Xinyuan-LilyGO/T-Motor/case/T-Motor.DXF

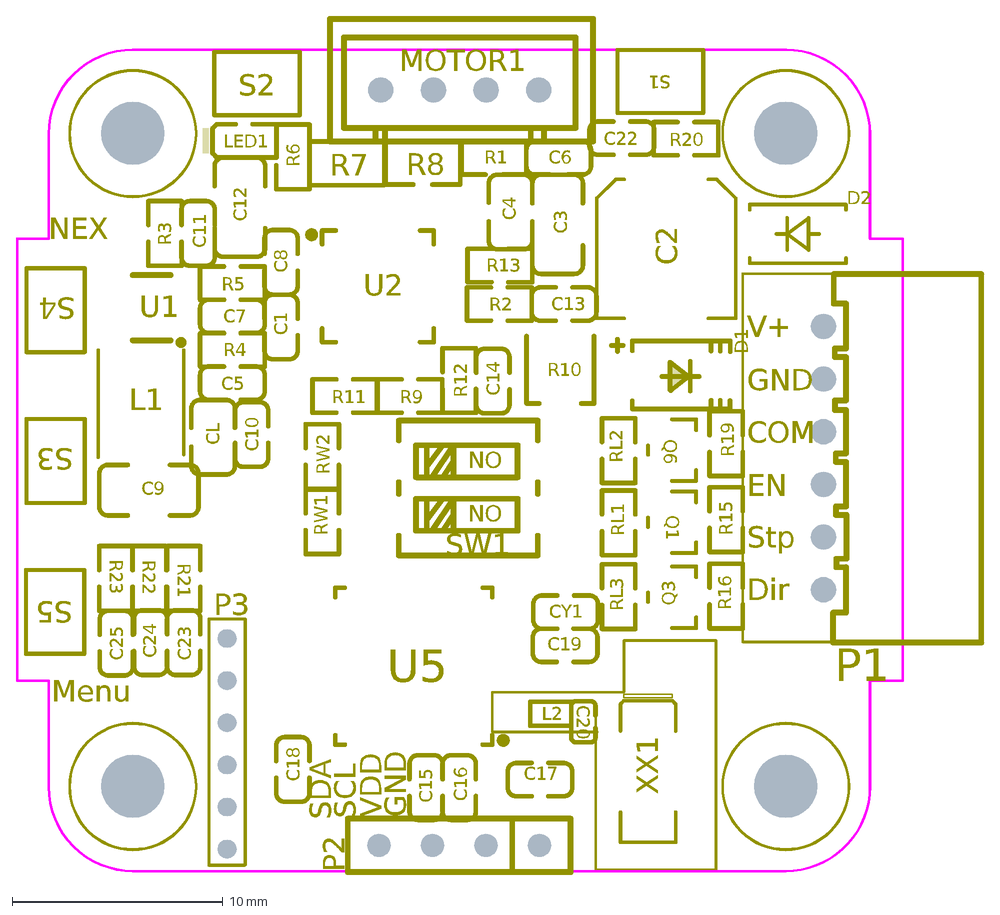
[picture p4: CAD file, 2025-07-31]
case/T-Motor.DXF
GND
VDD
SCL
SDA
Menu
NEX
Stp
Dir
COM
V+
EN
RL3
RL2
RL1
Q6
Q3
Q1
C19
D1
CL
U1
S5
S2
S4
S3
R23
R22
R21
C25
C24
C23
C2
XX1
U5
S1
R20
R13
R12
R11
R10
R9
R8
R7
R6
R2
R1
P3
P1
LED1
L2
D2
C22
C20
C17
C16
C15
C14
C13
C8
C12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
