Xinyuan-LilyGO/T-Motor/case/Shell.stl

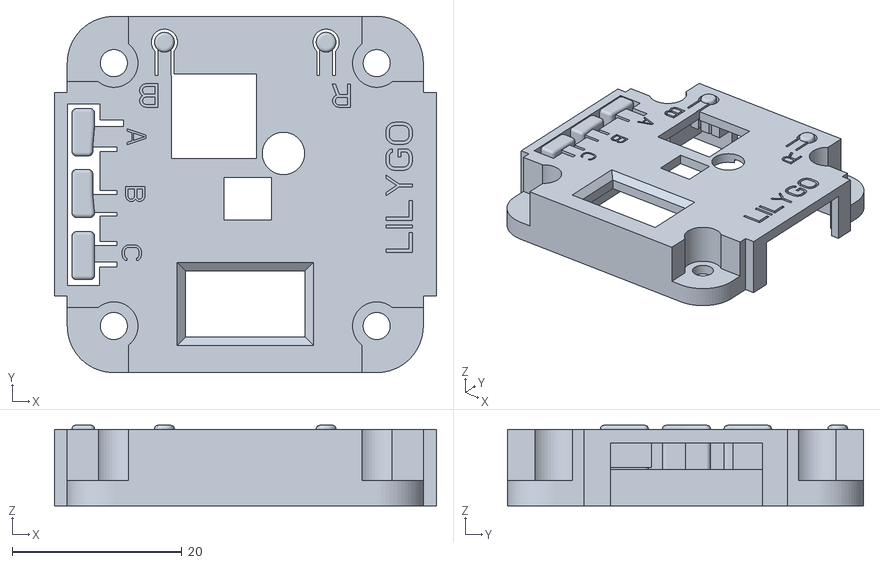
[picture p5: CAD file, 2021-11-24]
case/Shell.stl
45.1 x 42.0 x 9.50
