Xinyuan-LilyGO/T-Motor/Schematic/T-Motor.pdf

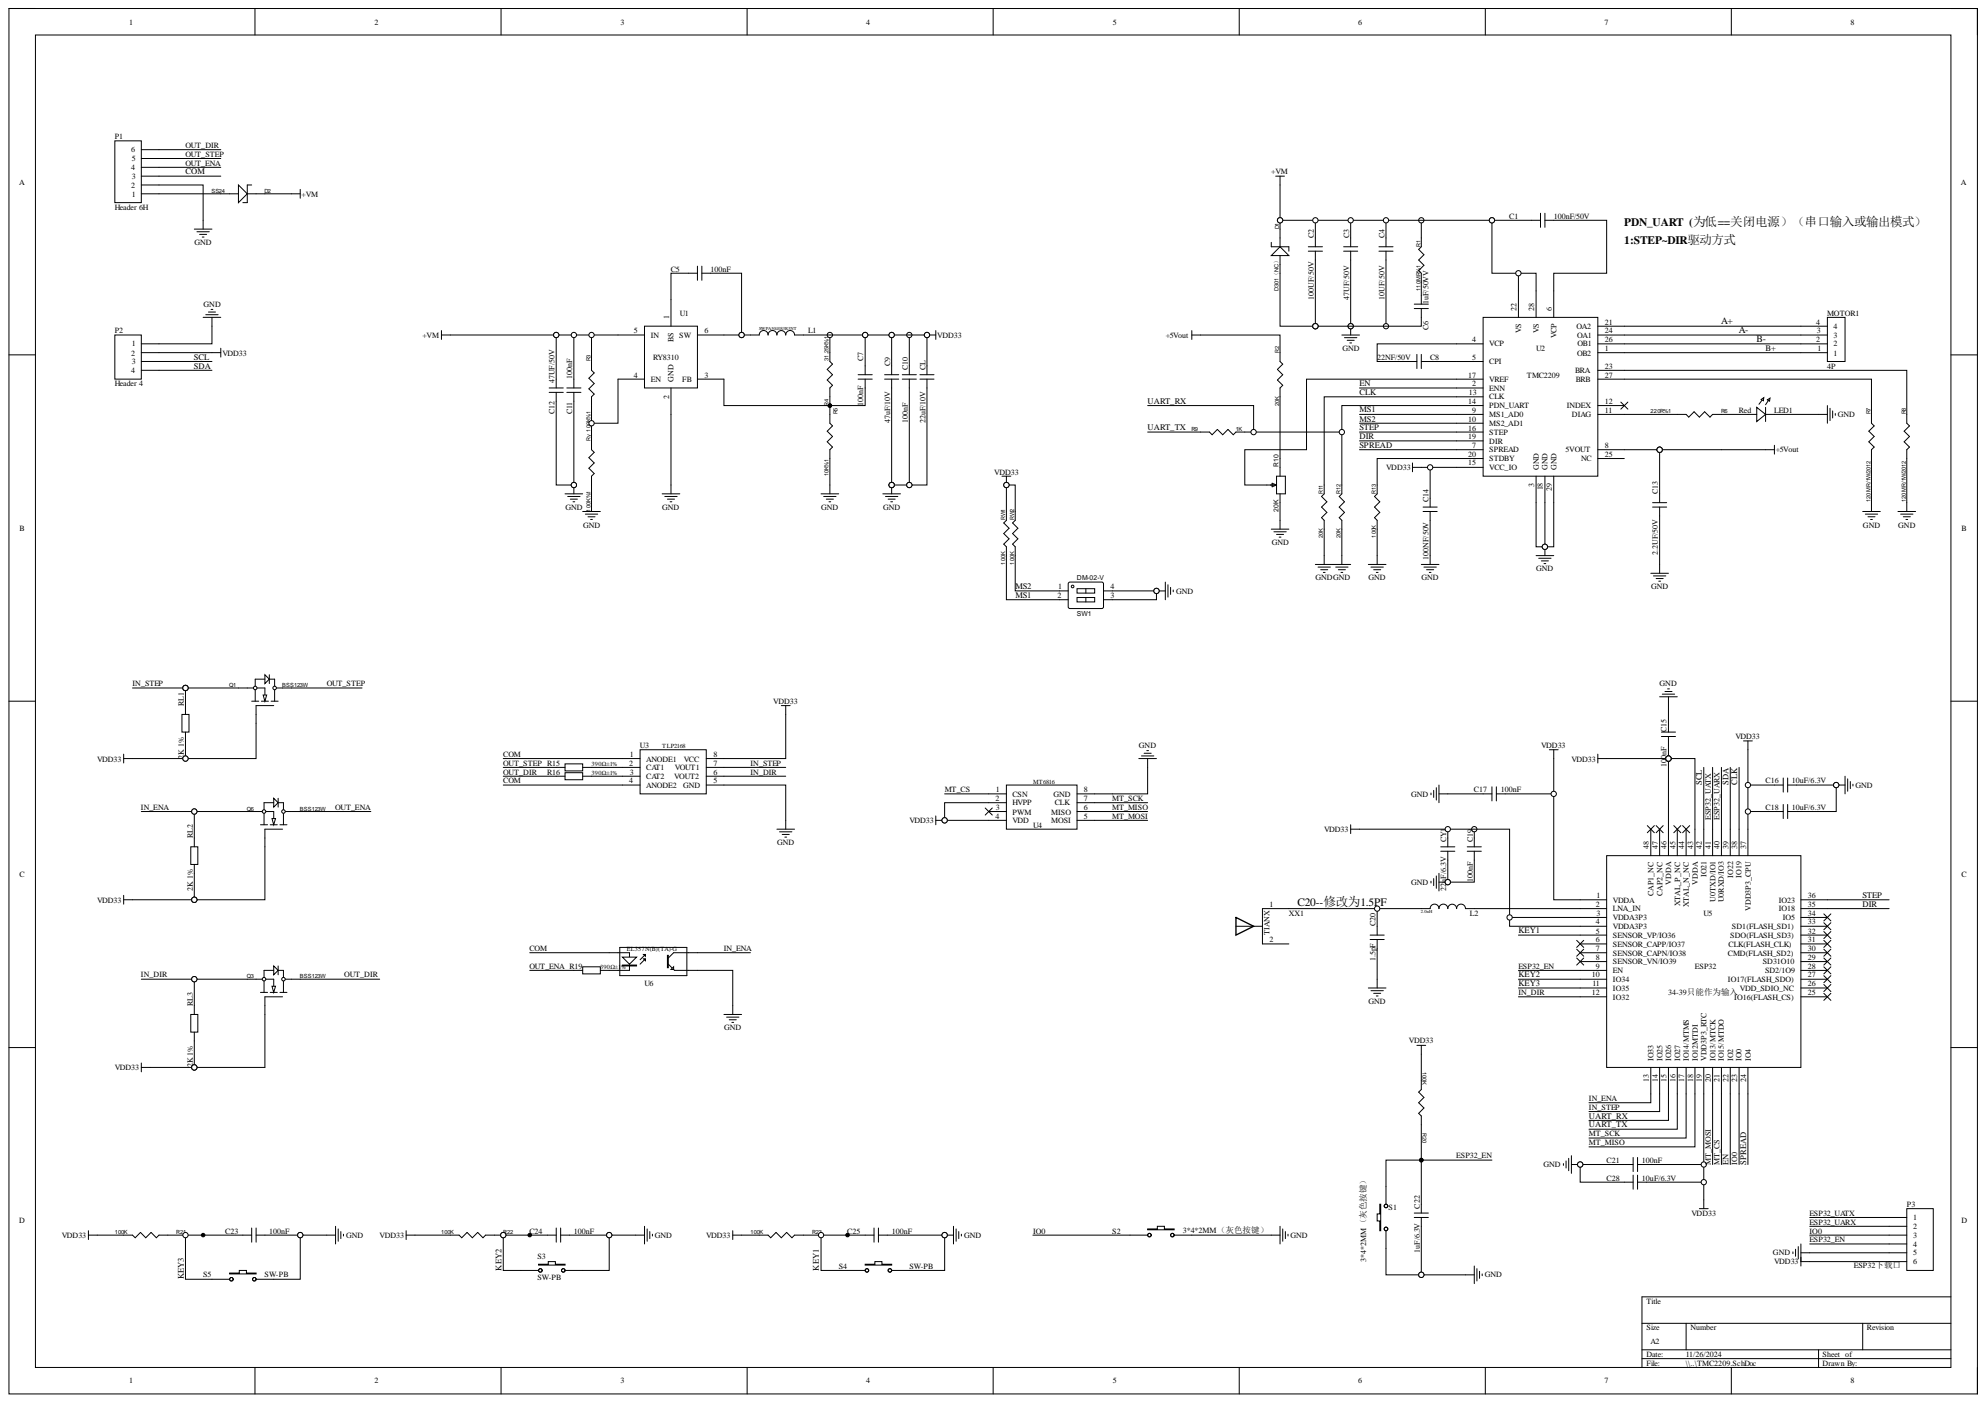
[picture p6: page 1]
