Xinyuan-LilyGO/T-Motor/(threads)

Thread 1 (2022-02-16):

Uart and diag pin available?

Biorn1950, 2022-02-16:
Hello,

Are the tmc uart and diag pin connected to the esp32?

Do you have schematics available?

thanks

LilyGO, 2022-04-20:
It is connected to ESP32, 26, 27 respectively. It will eventually be connected to a pin of TMC

Closed 2022-04-20.

Thread 3 (2024-08-27):

Pin error between Schematic diagram and Code and other questions

joelcollet, 2024-08-27:
Hi

I recently bought a lilygo T-motor board (not received yet) and i am wondering about the mismatch between the code and the schematic for some pins

First question: on the github, in schematic T_motor.pdf file
the UART_RX and UART_TX pins for the TMC2209 are connected to IO25(pin 14) and IO26(pin 15) on the schematic while the code is using IO26 and IO27
#define SW_RX 26 // TMC2208/TMC2224 SoftwareSerial receive pin
#define SW_TX 27 // TMC2208/TMC2224 SoftwareSerial transmit pin
i wanted to know which one is correct , the schematic or the code ? since the schematic looks to have been  updated in 2023  and code 3 years ago.
I also  own a schematic from 2022 which looks different but whihc is in agreement with the code .

Second question:
on the schematic there is a U3 chip which looks like to be not present on the board.
- to which ESP32 pins are connected VOUT1(STEP in green) and VOUT2 (DIR in greeen), if any ? as well as the CLK- and DIR- ?
on the U6 chip (also missing) , same question for EN- and ENIN

last question:
 can we use the STEP/DIR/ENA connection  of the header1 as input or is it only output ?

Regards

J. collet

lewisxhe, 2025-07-31:
The schematic diagram has been updated in time

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

Thread 5 (2025-09-01):

Incorrect DRIVER_ADDRESS in examples

OJUrbaniak, 2025-09-01:
Through some trial and error, I have found that the address for the motor driver on this board seems to be `0b11`, not the `0b00` that is set in the factory example. This meant that any settings I set on the `driver` wouldn't take effect (e.g., microsteps would remain set to 256 regardless of the code). Could this please be corrected/investigated so that others don't encounter the issue?

Kind regards

lewisxhe, 2025-09-03:
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
Address configuration by SW1
