Xinyuan-LilyGO/T-Motor/(commit log)

2021-11-24 image commit
    [Shell.stl]
2025-07-18 Compatible with Arduino IDE
2025-07-31 Updated directory structure and examples
    [Shell.stl]
2025-07-31 Add dimensional drawing https://github.com/Xinyuan-LilyGO/T-Motor/issues/4
    [T-Motor.DXF]
